BenKohn2004/BellGuard_Insert_Accelerometer/Installed in an Epee.jpg

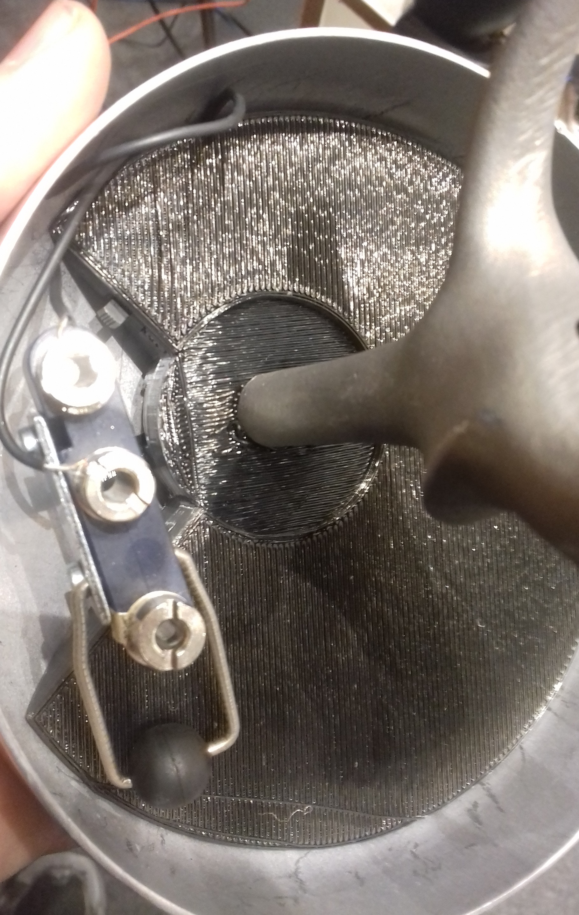
Installed in an Epee.jpg
