BenKohn2004/BellGuard_Insert_Accelerometer/Inside of the Insert.jpg

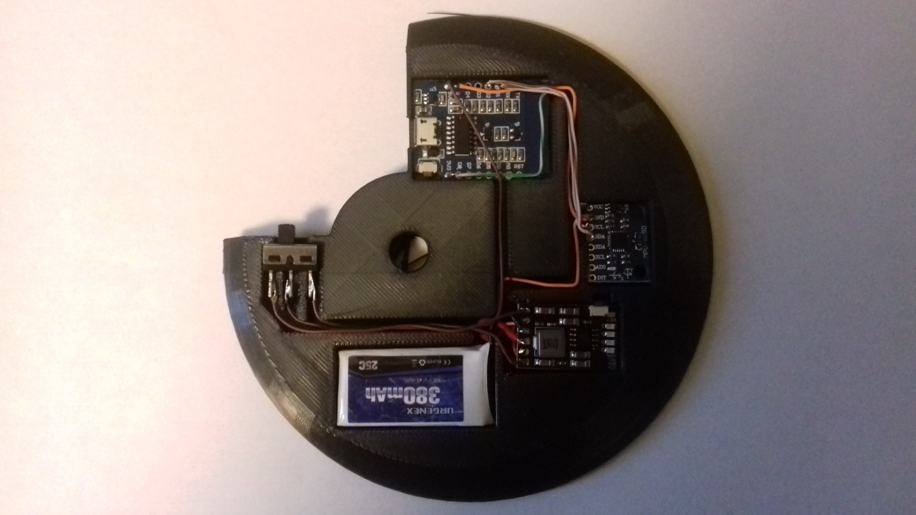
Inside of the Insert.jpg
