BenKohn2004/BellGuard_Insert_Accelerometer/README.md

# BellGuard_Insert_Accelerometer
A Bellguard Insert for an epee that can measure acceleration and transmit wirelessly to a receiver. The general layout can be seen in the schematic [Schematic Epee Bellguard Insert and Speaker.pdf](https://github.com/BenKohn2004/BellGuard_Insert_Accelerometer/blob/main/Schematic%20Epee%20Bellguard%20Insert%20and%20Speaker.pdf). The insert effectively replaces the bell pad and requires about 2 cm of extra length on the blade between the handle and the bellguard.

The Bellguard Insert is modeled using [OnShape](https://cad.onshape.com/documents/51ca8c06bc5b5404b12fe69e/w/3a4a6ec2c7af2a419aeb4d50/e/05886a4a9ec08934e00e5f42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), an example can be found at [3D Model of the Insert.png](https://raw.githubusercontent.com/BenKohn2004/BellGuard_Insert_Accelerometer/main/3D%20Model%20of%20the%20Insert.png). The assembled and wired insert would look like [this](https://raw.githubusercontent.com/BenKohn2004/BellGuard_Insert_Accelerometer/main/Inside%20of%20the%20Insert.jpg).

A [Wemos](https://www.amazon.com/Organizer-ESP8266-Internet-Development-Compatible/dp/B081PX9YFV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) D1 Mini is used to control an accelerometer, [MPU6050](https://www.amazon.com/HiLetgo-MPU-6050-Accelerometer-Gyroscope-Converter/dp/B00LP25V1A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), and is charged using an [MH-CD42 Module](https://www.amazon.com/Discharge-Integrated-Charging-Protection-Converter/dp/B0836J8LR4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) along with a [Lithium Polymer Drone Battery](https://www.amazon.com/URGENEX-380mAh-Battery-Charger-Controller/dp/B08DD5MTKM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) which then connects wirelessly to an [ESP32](https://www.amazon.com/ESP-WROOM-32-Development-Microcontroller-Integrated-Compatible/dp/B08D5ZD528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) which drives a [MAX98357A](https://www.amazon.com/Teyleten-Robot-Amplifier-Interface-Filterless/dp/B0B4GK5R1R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) amplifier module which is connected to a speaker. The mp3 sounds that are played are stored on an SD Card connected to the ESP32 and are randomly chosen each time the acceleration threshold is met on the Epee Bellguard Insert.

An example of the insert working can be seen on [Youtube](https://youtu.be/urIJzAw4_HY).

The goal of the project was to create a small, wireless, battery powered attachment that could be used with a fencing weapon to measure acceleration. A benefit of the accelerometer is that it can also measure orientation such as Roll, Pitch and Yaw.

One idea is that an SD card could be added to the bellguard insert so that the data could be easily recorded from a fencing match. This would allow a higher sampling rate than transmitting the data after each sample and then the data could be saved and transmitter after each touch. Combining and coordinating the insert with a scoring machine, such as a Favero Full Arm 05, the data could automatically be sent following a touch. This would allow one to analyze the acceleration and orientation of the fencer's bellguard during the encounter and potentially reconstruct the action. This could be done using bellguard inserts for both fencers simultaneously so that interactions between the fencers could be mapped.

Similarly, one could argue that the most important move in fencing is the extension, which is surprisingly nuanced. Tracking the acceleration and orientation of the extension might provide interesting insights and allow for more effective coaching techniques.
