BenKohn2004/BellGuard_Insert_Accelerometer/3D Model of the Insert.png

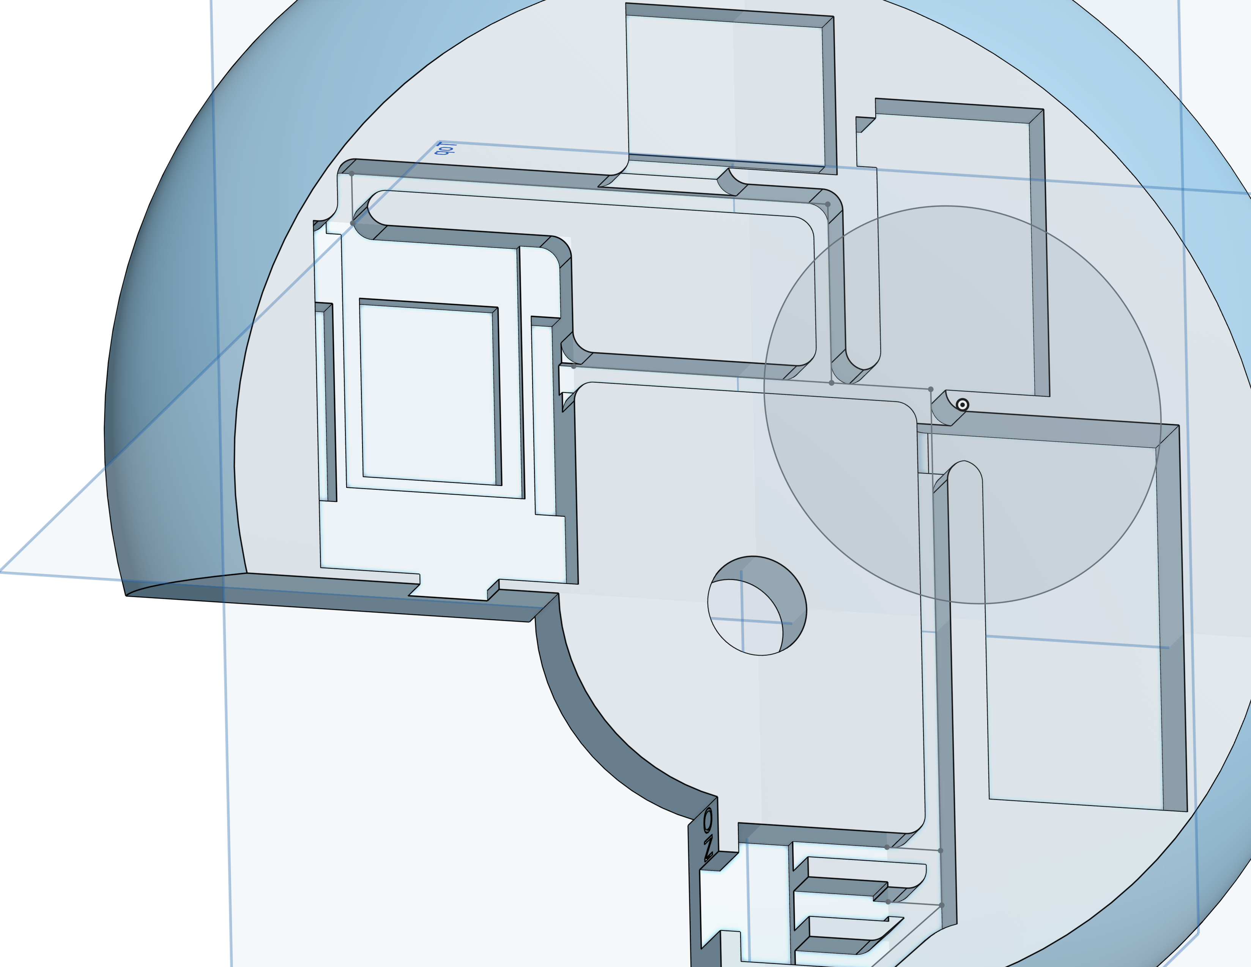
3D Model of the Insert.png
