BenKohn2004/BellGuard_Insert_Accelerometer/Schematic Epee Bellguard Insert and Speaker.pdf

BellGuard Insert | Speaker

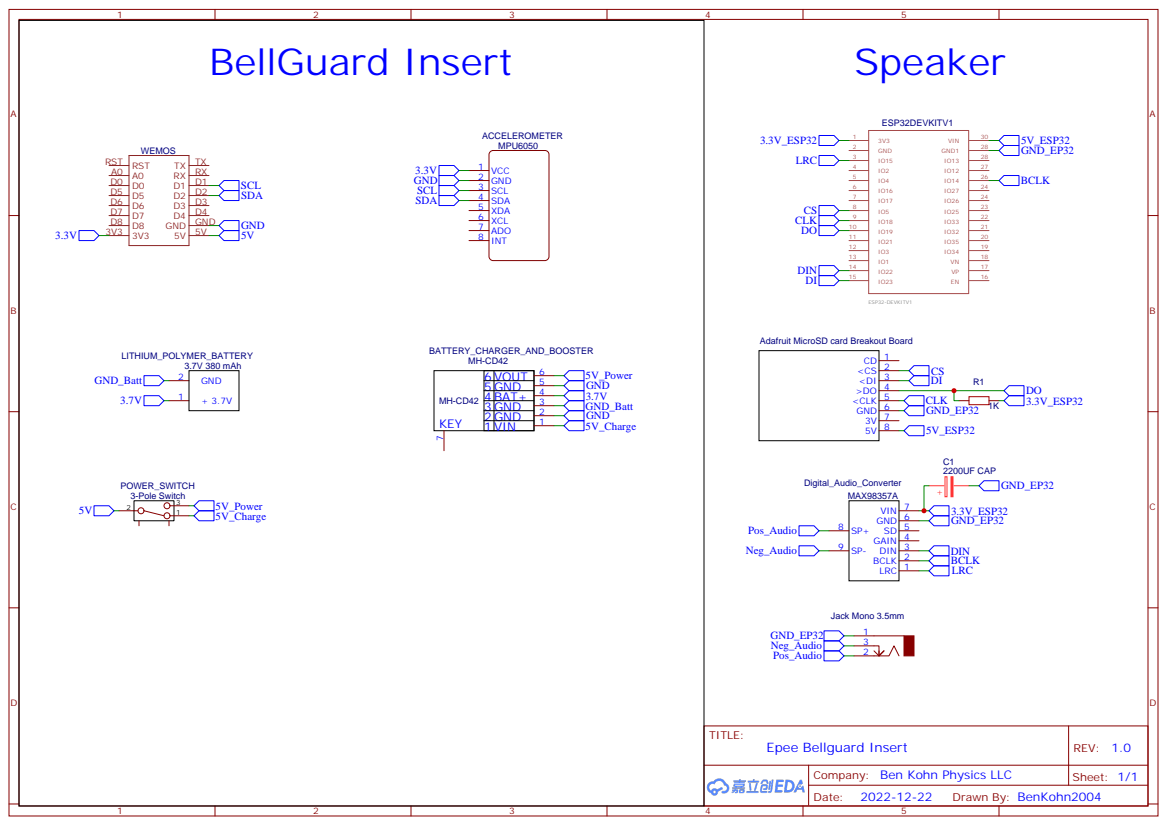
[picture p4: page 1]

Adafruit MicroSD card Breakout Board

Company: Ben Kohn Physics LLC
